pstiasny/tv-doom/hardware/tvplug2.kicad_pcb

## KiCad design hardware/tvplug2.kicad_pcb (2026-10-08)

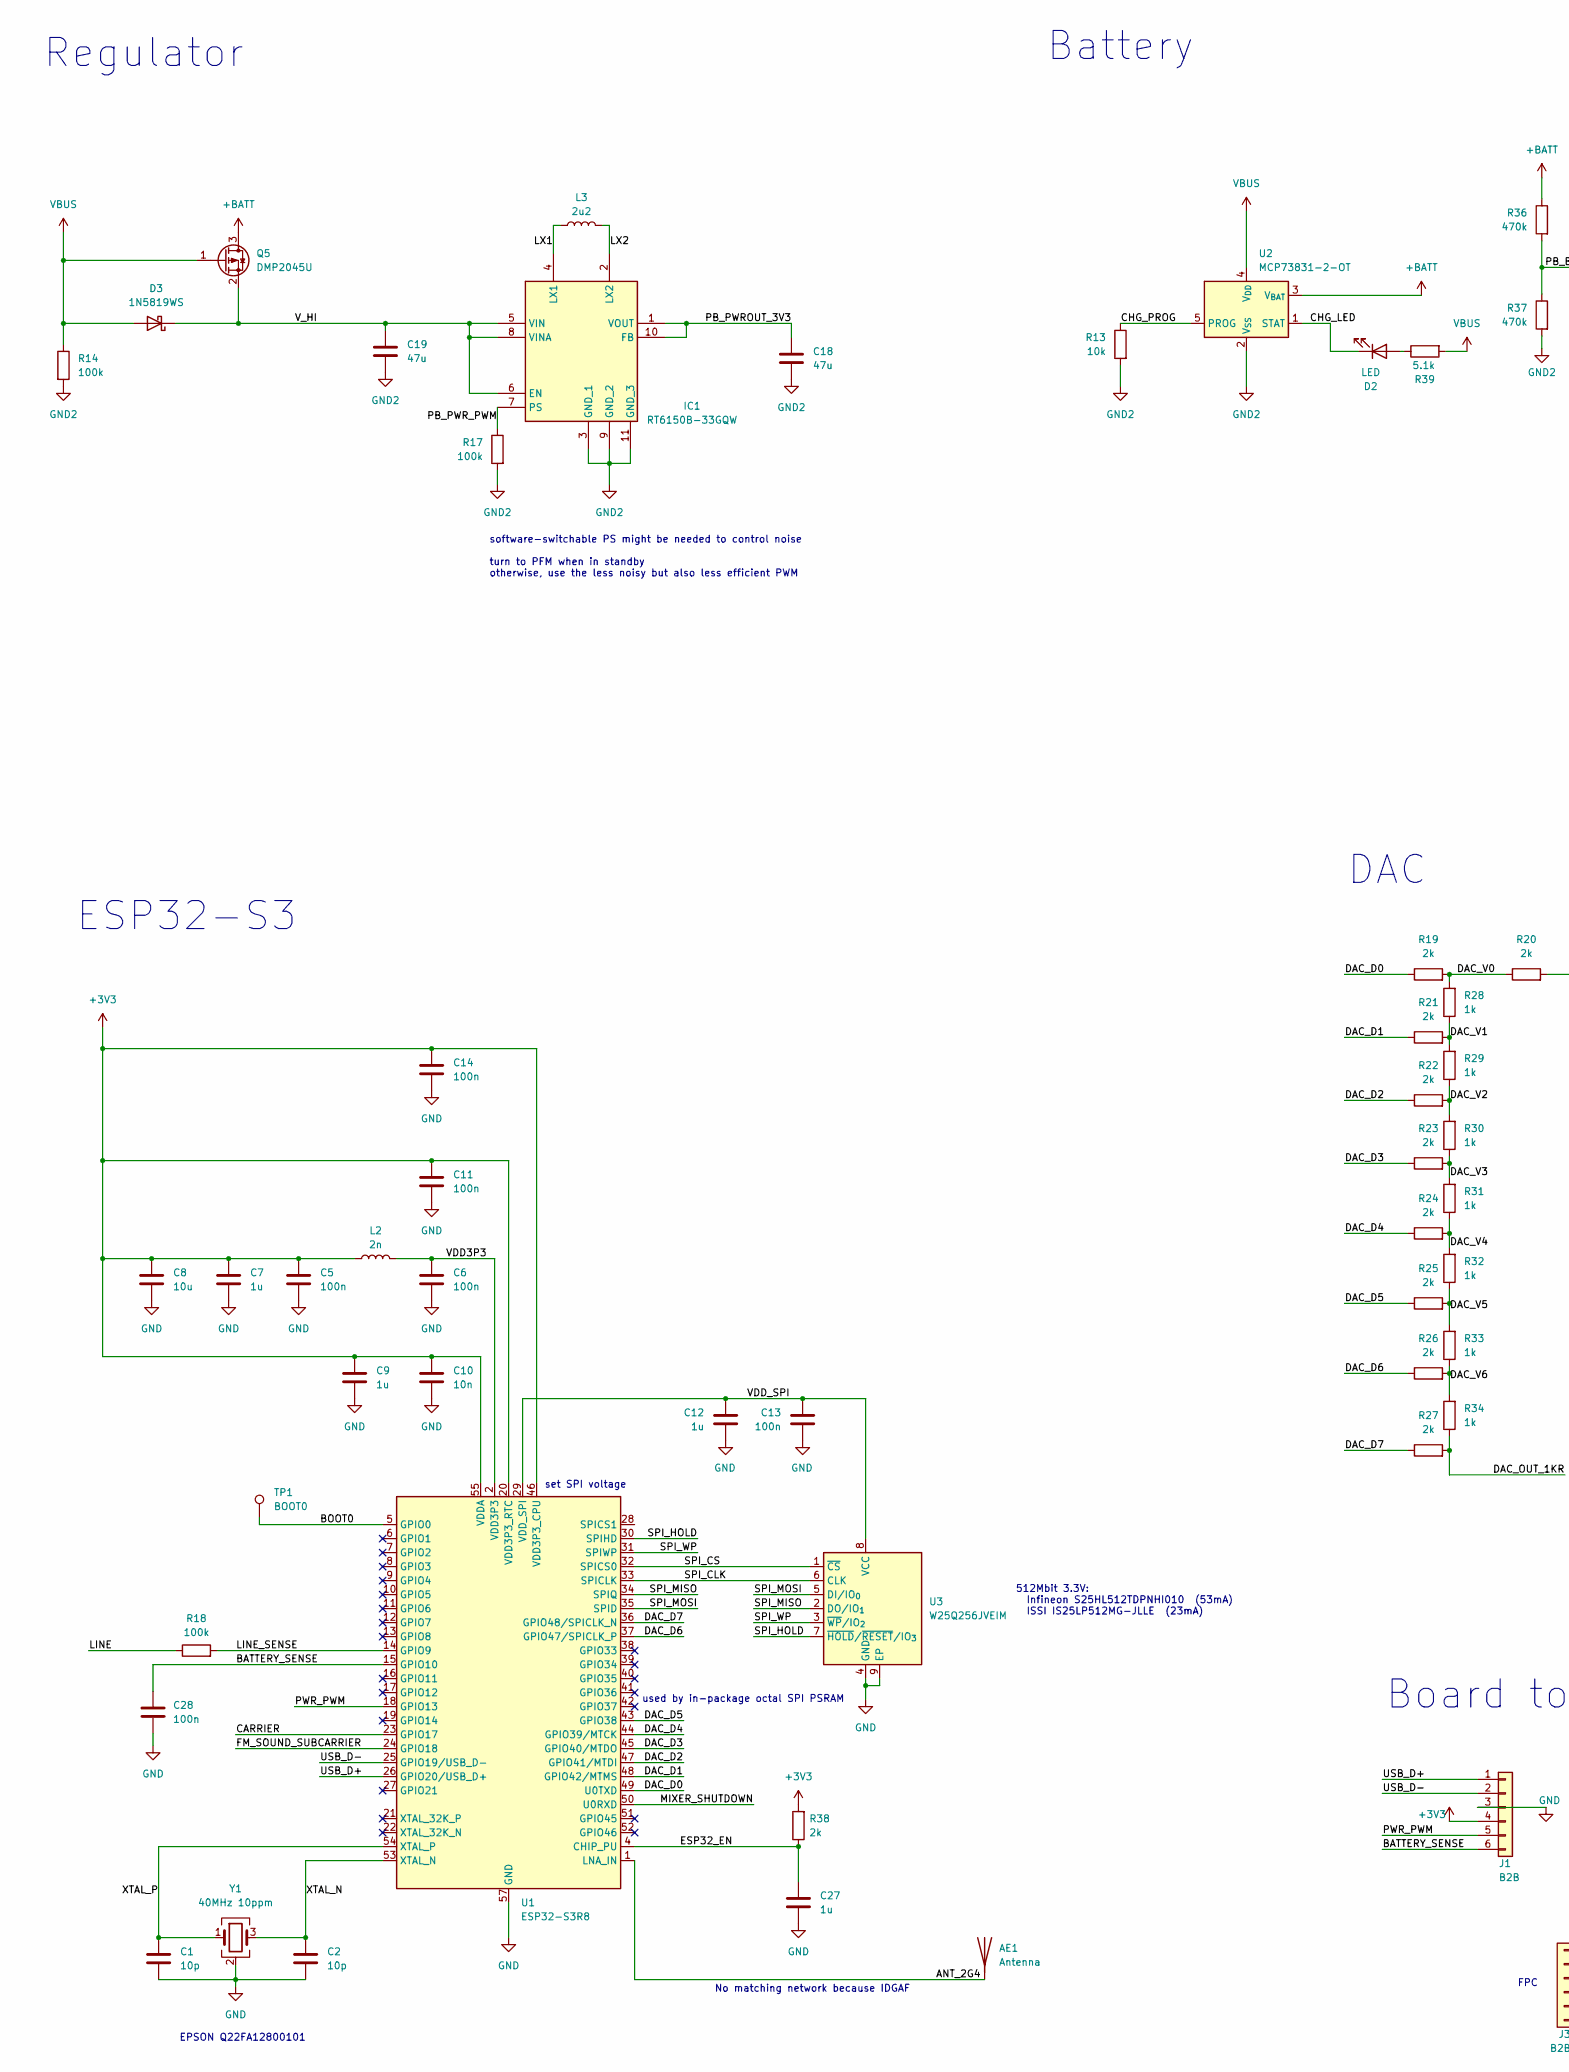
[picture p1: schematic tvplug2.kicad_sch, part in row 1, column 1]

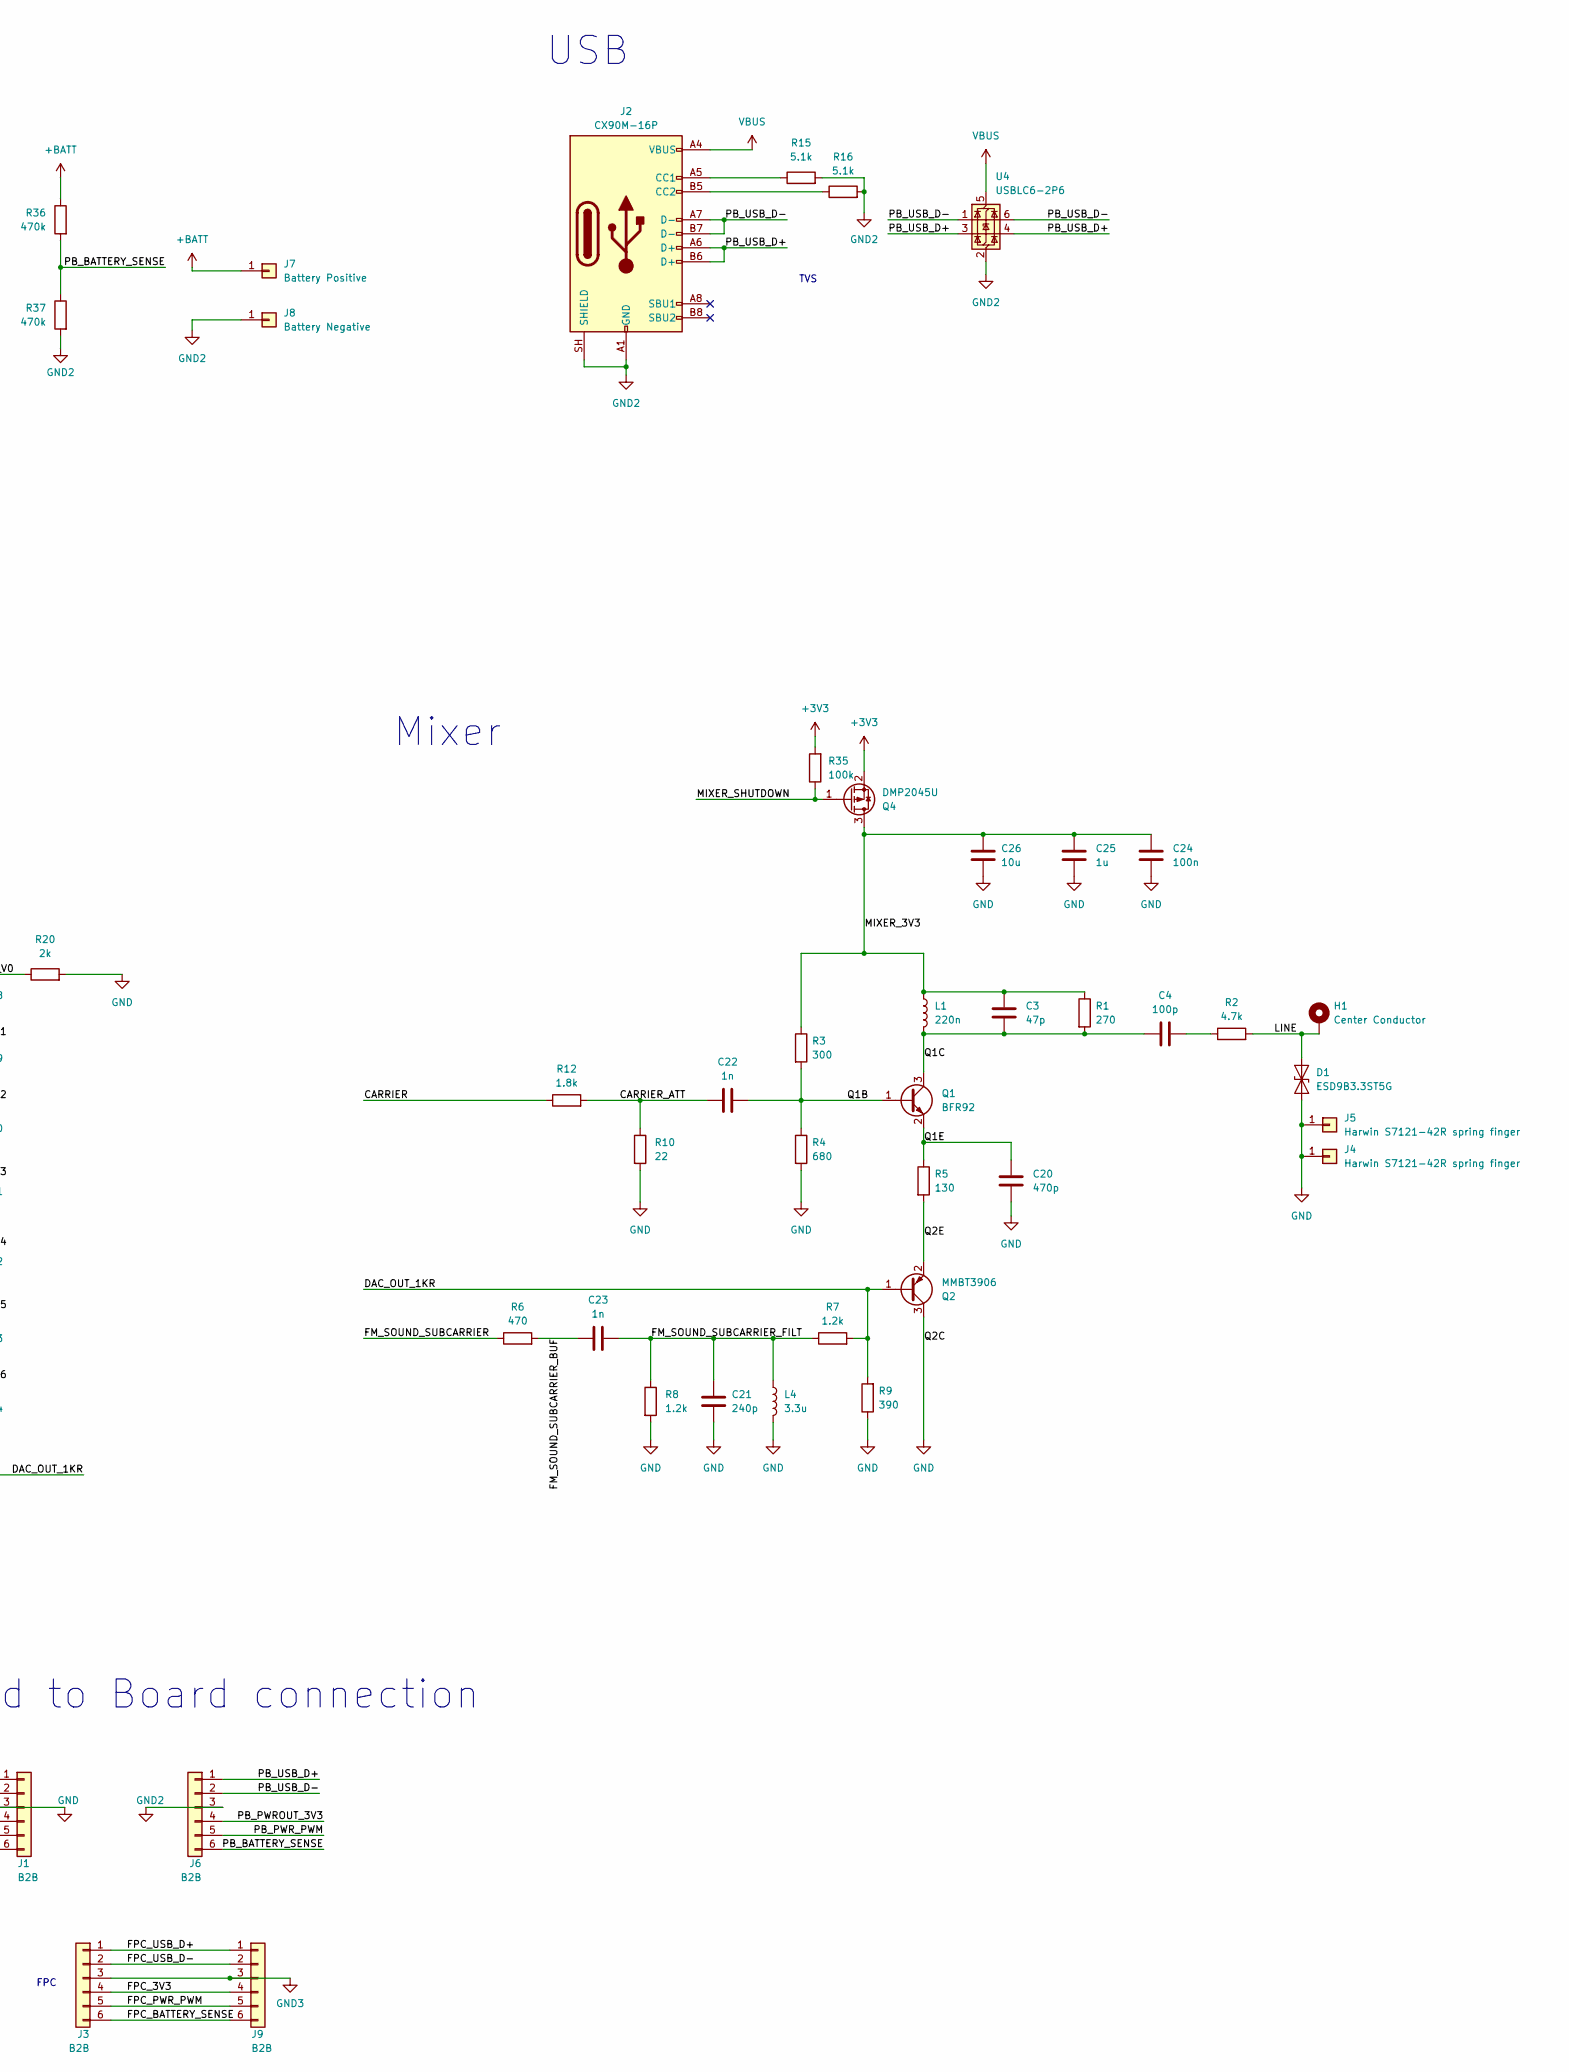
[picture p2: schematic tvplug2.kicad_sch, part in row 1, column 2]

Parts:
AE1: Antenna; TestPoint_Pad_1.0x1.0mm
C1, C2: 10p; C_0402_1005Metric
C3: 47p; C_0402_1005Metric
C4: 100p; C_0402_1005Metric
C5, C6, C11, C13, C14, C24, C28: 100n; C_0402_1005Metric
C7, C9, C12, C25, C27: 1u; C_0402_1005Metric
C8, C26: 10u; C_0402_1005Metric
C10: 10n; C_0402_1005Metric
C18, C19: 47u; C_0805_2012Metric
C20: 470p; C_0402_1005Metric
C21: 240p; C_0402_1005Metric
C22, C23: 1n; C_0402_1005Metric
D1: ESD9B3.3ST5G; D_SOD-923
D2: LED; LED_0603_1608Metric
D3: 1N5819WS; D_SOD-323
H1: Center Conductor; MountingHole_3.2mm_M3_Pad_Via
IC1: RT6150B-33GQW; SON50P250X250X80-11N-D; Mouser Part Number 835-RT6150B-33GQW
J1, J6: B2B; B2B_flex
J2: CX90M-16P; USB_C_Receptacle_Hirose_CX90M-16P_MidMount
J3, J9: B2B; B2B_flex_opposite
J4, J5: Harwin S7121-42R spring finger; S712142R
J7: Battery Positive; SolderWirePad_1x01_SMD_1.5x3mm
J8: Battery Negative; SolderWirePad_1x01_SMD_1.5x3mm
L1: 220n; L_0402_1005Metric
L2: 2n; L_0402_1005Metric
L3: 2u2; SPM3010-3020
L4: 3.3u; L_0402_1005Metric
Q1: BFR92; SOT-323_SC-70
Q2: MMBT3906; SOT-23
Q4, Q5: DMP2045U; SOT-23
R1: 270; R_0402_1005Metric
R2: 4.7k; R_0402_1005Metric
R3: 300; R_0402_1005Metric
R4: 680; R_0402_1005Metric
R5: 130; R_0402_1005Metric
R6: 470; R_0402_1005Metric
R7, R8: 1.2k; R_0402_1005Metric
R9: 390; R_0402_1005Metric
R10: 22; R_0402_1005Metric
R12: 1.8k; R_0402_1005Metric
R13: 10k; R_0402_1005Metric
R14, R17, R18, R35: 100k; R_0402_1005Metric
R15, R16, R39: 5.1k; R_0402_1005Metric
R19, R20, R21, R22, R23, R24, R25, R26, R27, R38: 2k; R_0402_1005Metric
R28, R29, R30, R31, R32, R33, R34: 1k; R_0402_1005Metric
R36, R37: 470k; R_0402_1005Metric
TP1: BOOT0; TestPoint_Pad_D1.0mm
U1: ESP32-S3R8; QFN-56-1EP_7x7mm_P0.4mm_EP4x4mm
U2: MCP73831-2-OT; SOT-23-5
U3: W25Q256JVEIM; WSON-8-1EP_8x6mm_P1.27mm_EP3.4x4.3mm
U4: USBLC6-2P6; SOT-666
Y1: 40MHz 10ppm; Crystal_SMD_2016-4Pin_2.0x1.6mm

Connections:
+3V3: C5.1, C7.1, C8.1, C9.1, C10.1, C11.1, C14.1, J1.4, L2.1, Q4.2 (S), R35.2, R38.2, U1.20 (VDD3P3_RTC), U1.46 (VDD3P3_CPU), U1.55 (VDDA), U1.56 (VDDA)
+BATT: J7.1 (Pin_1_1), Q5.3 (D), R36.1, U2.3 (V_{BAT})
/ANT_2G4: AE1.1 (A_1), U1.1 (LNA_IN)
/BATTERY_SENSE: C28.2, J1.6, U1.15 (GPIO10)
/BOOT0: TP1.1 (1_1), U1.5 (GPIO0)
/CARRIER: R12.1, U1.23 (GPIO17)
/CARRIER_ATT: C22.1, R10.1, R12.2
/CHG_LED: D2.1 (K), U2.1 (STAT)
/CHG_PROG: R13.1, U2.5 (PROG)
/DAC_D0: R19.1, U1.49 (U0TXD)
/DAC_D1: R21.1, U1.48 (GPIO42/MTMS)
/DAC_D2: R22.1, U1.47 (GPIO41/MTDI)
/DAC_D3: R23.1, U1.45 (GPIO40/MTDO)
/DAC_D4: R24.1, U1.44 (GPIO39/MTCK)
/DAC_D5: R25.1, U1.43 (GPIO38)
/DAC_D6: R26.1, U1.37 (GPIO47/SPICLK_P)
/DAC_D7: R27.1, U1.36 (GPIO48/SPICLK_N)
/DAC_OUT_1KR: Q2.1 (B), R7.2, R9.2, R27.2, R34.1
/DAC_V0: R19.2, R20.1, R28.2
/DAC_V1: R21.2, R28.1, R29.2
/DAC_V2: R22.2, R29.1, R30.2
/DAC_V3: R23.2, R30.1, R31.2
/DAC_V4: R24.2, R31.1, R32.2
/DAC_V5: R25.2, R32.1, R33.2
/DAC_V6: R26.2, R33.1, R34.2
/ESP32_EN: C27.1, R38.1, U1.4 (CHIP_PU)
/FM_SOUND_SUBCARRIER: R6.1, U1.24 (GPIO18)
/FM_SOUND_SUBCARRIER_BUF: C23.1, R6.2
/FM_SOUND_SUBCARRIER_FILT: C21.1, C23.2, L4.1, R7.1, R8.1
/FPC_3V3: J3.4, J9.4
/FPC_BATTERY_SENSE: J3.6, J9.6
/FPC_PWR_PWM: J3.5, J9.5
/FPC_USB_D+: J3.1, J9.1
/FPC_USB_D-: J3.2, J9.2
/LINE: D1.2 (A2), H1.1 (1_1), R2.2, R18.1
/LINE_SENSE: R18.2, U1.14 (GPIO9)
/LX1: IC1.4 (LX1), L3.1
/LX2: IC1.2 (LX2), L3.2
/MIXER_3V3: C3.1, C24.1, C25.1, C26.1, L1.1, Q4.3 (D), R1.1, R3.1
/MIXER_SHUTDOWN: Q4.1 (G), R35.1, U1.50 (U0RXD)
/PB_BATTERY_SENSE: J6.6, R36.2, R37.1
/PB_PWROUT_3V3: C18.1, IC1.1 (VOUT), IC1.10 (FB), J6.4
/PB_PWR_PWM: IC1.7 (PS), J6.5, R17.1
/PB_USB_D+: J2.A6 (D+), J2.B6 (D+), J6.1, U4.3 (I/O2), U4.4 (I/O2)
/PB_USB_D-: J2.A7 (D-), J2.B7 (D-), J6.2, U4.1 (I/O1), U4.6 (I/O1)
/PWR_PWM: J1.5, U1.18 (GPIO13)
/Q1B: C22.2, Q1.1 (B), R3.2, R4.1
/Q1C: C3.2, C4.1, L1.2, Q1.3 (C), R1.2
/Q1E: C20.1, Q1.2 (E), R5.1
/Q2E: Q2.2 (E), R5.2
/SPI_CLK: U1.33 (SPICLK), U3.6 (CLK)
/SPI_CS: U1.32 (SPICS0), U3.1 (~CS)
/SPI_HOLD: U1.30 (SPIHD), U3.7 (~HOLD/~RESET/IO_{3})
/SPI_MISO: U1.34 (SPIQ), U3.2 (DO/IO_{1})
/SPI_MOSI: U1.35 (SPID), U3.5 (DI/IO_{0})
/SPI_WP: U1.31 (SPIWP), U3.3 (~WP/IO_{2})
/USB_D+: J1.1, U1.26 (GPIO20/USB_D+)
/USB_D-: J1.2, U1.25 (GPIO19/USB_D-)
/VDD3P3: C6.1, L2.2, U1.2 (VDD3P3), U1.3 (VDD3P3)
/VDD_SPI: C12.1, C13.1, U1.29 (VDD_SPI), U3.8 (VCC)
/V_HI: C19.1, D3.1 (K), IC1.5 (VIN), IC1.6 (EN), IC1.8 (VINA), Q5.2 (S)
/XTAL_N: C2.1, U1.53 (XTAL_N), Y1.3
/XTAL_P: C1.1, U1.54 (XTAL_P), Y1.1
GND: C1.2, C2.2, C5.2, C6.2, C7.2, C8.2, C9.2, C10.2, C11.2, C12.2, C13.2, C14.2, C20.2, C21.2, C24.2, C25.2, C26.2, C27.2, C28.1, D1.1 (A1), J1.3, J4.1 (Pin_1_1), J5.1 (Pin_1_1), L4.2, Q2.3 (C), R4.2, R8.2, R9.1, R10.2, R20.2, U1.57 (GND), U3.4 (GND), U3.9 (EP), Y1.2 (G), Y1.4 (G)
GND2: C18.2, C19.2, IC1.3 (GND_1), IC1.9 (GND_2), IC1.11 (GND_3), J2.A1 (GND), J2.A12 (GND), J2.B1 (GND), J2.B12 (GND), J2.SH (SHIELD), J6.3, J8.1 (Pin_1_1), R13.2, R14.2, R15.2, R16.2, R17.2, R37.2, U2.2 (V_{SS}), U4.2 (GND)
GND3: J3.3, J9.3
unnamed: C4.2, R2.1
unnamed: D2.2 (A), R39.1
unnamed: J2.A5 (CC1), R15.1
unnamed: J2.B5 (CC2), R16.1
VBUS: D3.2 (A), J2.A4 (VBUS), J2.A9 (VBUS), J2.B4 (VBUS), J2.B9 (VBUS), Q5.1 (G), R14.1, R39.2, U2.4 (V_{DD}), U4.5 (VBUS)

Notes on the sheet:
USB
Board to Board connection
EPSON Q22FA12800101
Mixer
DAC
FPC
used by in-package octal SPI PSRAM
ESP32-S3
TVS
Regulator
512Mbit 3.3V: Infineon S25HL512TDPNHI010 (53mA) ISSI IS25LP512MG-JLLE (23mA)
software-switchable PS might be needed to control noise turn to PFM when in standby otherwise, use the less noisy but also less efficient PWM
No matching network because IDGAF
set SPI voltage
Battery

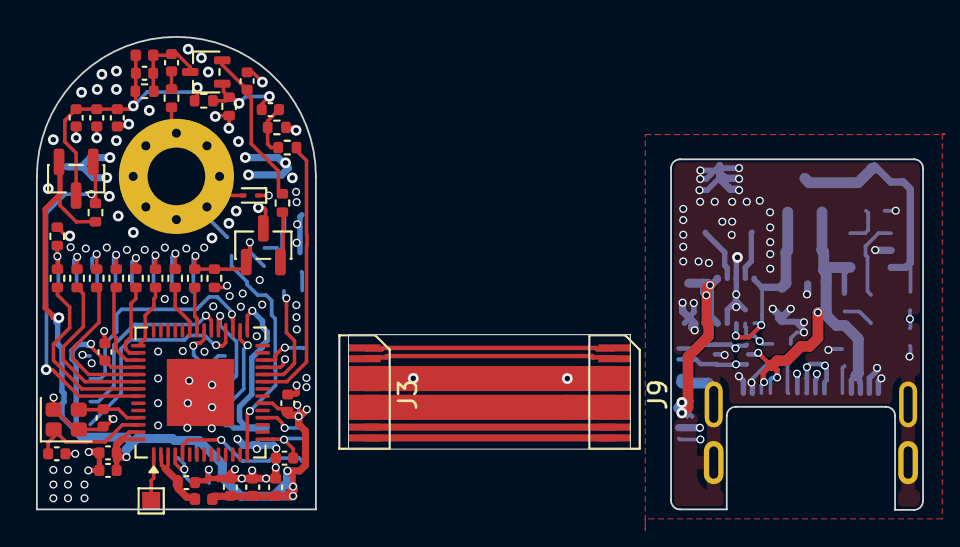
[picture p3: board tvplug2.kicad_pcb from above]

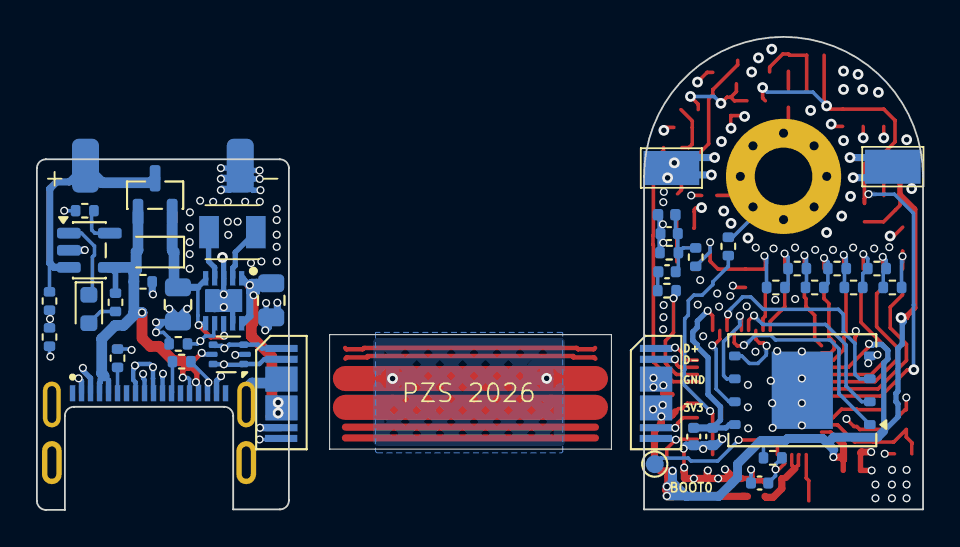
[picture p4: board tvplug2.kicad_pcb from below]

Board: 4 copper layers, 49.2 x 26.3 mm, 92 parts (44 on the bottom side), 71 nets.
